Alex-f98/Circuitos2-FIUBA/Versión_Final/PCB-V3/TP-PCB/TP-PCB.png

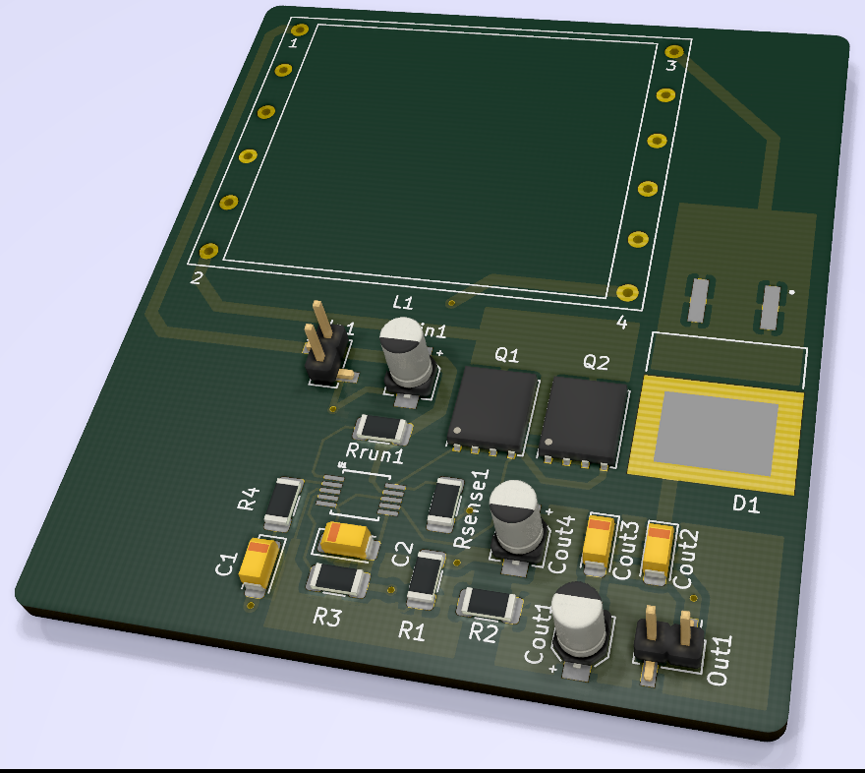
Versión_Final/PCB-V3/TP-PCB/TP-PCB.png
