Alex-f98/Circuitos2-FIUBA/README.md

Los archivos de cursas son muy pesados para subir al github.

Solo se sube el TP final del mismo, dentro esta el informe.
Como fue un tp en donde se nos hacia seguimiento se pidio que el informe sea breve y presente solo resultados.
