Alex-f98/Circuitos2-FIUBA/Versión_Final/Proyecto Flyback - Version Final.pdf

# Diseño de Circuitos Electrónicos - Proyecto Final - Rev.1

Brian Fuentes - Elías Urquiza - José F. González - Mauro Nacachian

Julio 2021

## Índice

1. Especificaciones | 2
2. Topología | 2
3. Diseño Teórico | 2
4. Componentes | 4
5. Simulaciones | 7
6. Diseño del PCB | 10
7. Referencias | 11

Rev.1 Se definen las especificaciones.

Batería /

Alternador

11 V - 14 V
Encendedor
Vin Iin

Regulador

Vout Iout

Notebook

Pout = 97,5 W

19.5 V @ 5 A

Figura 1: Diagrama de Bloques con Especificaciones.

## 1. Especificaciones

Nos interesa diseñar un regulador conmutado para alimentar Notebooks conectadas al enchufe ’encededor’ de un automóvil como se muestra en la Figura 1. La tensión a regular proviene de la batería de valor nominal 12 V y debe elevarse al estandar de cargadores de notebook 19,5V@5A, luego la topología de conmutación deberá ser elevadora.
Las especificaciones a cumplir se resumen en el Cuadro 1.
Entrada | Salida | Regulador
Tensión | 11 V - 14 V | 19.5 V
Corriente | 9.2A | 5 A
Potencia | 110 W | 98,5 W
Eficiencia | 91 %

Cuadro 1: Especificaciones del regulador.

## 2. Topología

Para la selección de la topología se revisaron los estándares adoptados por la industria y resumidos en la Figura 2. El punto de operación elegido está levemente fuera de los estándares que tomamos como referencia, pero teniendo en cuenta que estos estándares fueron definidos empíricamente en 1990, y determinados por el estrés que pueden soportar los transistores de conmutación, consideramos que con las frecuencias de conmutación de los controladores actuales es posible salir de ese estándar de forma segura. En ese caso elegimos la fuente Flyback por su simplicidad y bajo costo, según los consejos de la cátedra.

## 3. Diseño Teórico

En la Figura 3 se muestra el esquemático simplificado de un regulador Flyback aislado. En un análisis preliminar se espera que el transistor de conmutación deberá soportar las siguientes condiciones
(
IDp ≈ 5,5 ×

P out
V in = 5,5 ×

100 W
11 V | = 50 Ap
VDp | ≈ V outmax

N1
N2 + V in = 30 V p

(1)

### 3.1. Frecuencia de Conmutación

La selección de la frecuencia está dada por una relación de compromiso entre los tamaños de los inductores y cuanta pérdida por conmutación se puede admitir. Mayores inductores aumentan la eficiencia pero son fisicamente más grandes y costosos.

Pout (W)

Vin (V)

1000

100

10

10 | 100 | 1000
Dominio Flyback | Half/Full Bridge

100 W

12 V

Figura 2: Diagrama de topologías adoptadas por la industria según la aplicación. Fuente: Practical Switching Power Supply Design – Marty Brown – Motorola. 1990

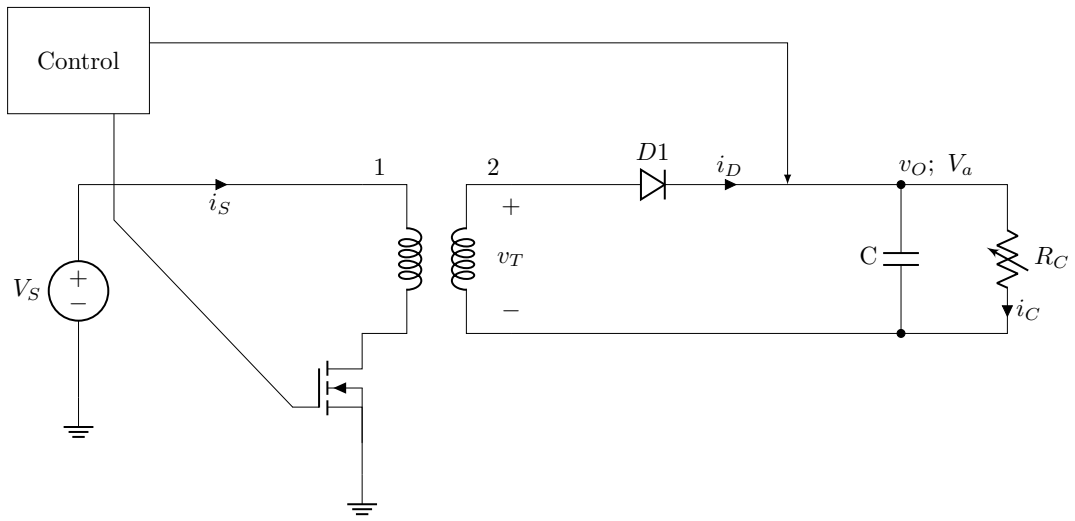
[picture p2: figure]
Control

Figura 3: Esquematico simplificado de un regulador Flyback aislado.

### 3.2. Ciclo de Trabajo

Cuando se opera al límite entre modo continuo y discontinuo el ciclo de trabajo relaciona la tensión de entrada con la salida según

D =

V out ·

N1
N2
V in +

N1
N2

V out

(2)

Cuando la tensión de entrada es mínima - 11 V - el ciclo de trabajo es máximo. Podemos fijar ese ciclo máximo a un 60 % y obtener una relación

N1
N2
= 0, 85 | (3)

### 3.3. Inductancia del Primario

El punto límite de funcionamiento es cuando la tensión de entrada es mínima y la corriente por el primario llega a un pico de

I1p = (1 −

∆IIN

2.IINavg

).P out.V in + V out.N
V in.V out.η.N
= 14A | (4)

Este valor condiciona a la tecnología de componentes para el dispositivo semiconductor y los inductores. Determina también la máxima dimensión del primario, luego la inductacia primaria a mínima entrada y máxima potencia de salida es

L1 =

V inmin × Dmax
∆I1 × f
= 62 uF | (5)

L2 = N

2
.L1 = 70uF | (6)
(
V pri = V sec ×

N1
N2
V sec = VD + V out

(7)

## 4. Componentes

### 4.1. Lista

Controlador | LTC1871
RRUN | 1 MΩ | -
R1 | 20 kΩ 1 % | -
R2 | 1,3 kΩ 1 % | -
R3 | 250 kΩ
R4 | 20 kΩ
RSENSE | 9 mΩ 1 % | IRC / TT Electronics
R4 | 20 kΩ | -
C1 | 35 nF | -
C2 | 4.7 uF 10V | X5R Kemet
CIn | 33 uF 35V | Tántalo
COut1 | 330 uF 35V | Electrolitico
COut2 | 330 uF 35V | Electrolitico
COut3 | 10 uF 35V | X5R Kemet
COut4 | 10 uF 35V | X5R Kemet
Diodo Schottky | MBR20100CT | TO-263
MOSFET | BSC035N04LS | -

### 4.2. Elección detrás de los elementos

En base al circuito propuesto de la figura 3 elegimos aquellos componentes reales, y la mayoría de ellos fácilmente adquiribles en el país, que nos permiten trabajar en el rango de entrada/salida propuesto.
Primeramente. elegimos el circuito integrado que actuará como controlador, decidiéndonos por el LTC1871 puesto que es apto para trabajar en modo de operación flyback, y requiere pocos componentes. Además, puede sensar al transistor de conmutación de dos formas distintas, una de ellas exclusiva para este controlador, pero finalmente decidimos manejarnos con el método de sensado tradicional, colocando el pin de sensado en el source.
Por otro lado, los transistores MOSFET elegidos son los BSC035N04LS, puesto que estos logran trabajar correctamente a la frecuencia de conmutación requerida, aunque para evitar que disipen demasiada potencia, se determinó que utilizar dos de ellos en paralelo era la opción óptima. Cabe destacar que estos componentes son los únicos que no se encuentran fácilmente en el país, por lo que en caso de no adquirirlos proponemos como reemplazo el transistor AOD4184. Otro componente de importancia es el diodo a utilizar, dado que este tendra una cierta caida de tensión entre sus bornes y debe ser capaz de soportar la corriente de salida y la frecuencia de conmutación de esta. Nos decidimos por el modelo MBR20100CT, el cual son 2 diodos Schottky en paralelo y tienen una caida de tension en directa de aproximadamente 0.8 V a la corriente instantanea de salida ( 10A). Una observacion respecto a este componente, es que en el pais se consigue facilmente con encapsulado TO-220, pero nosotros decidimos utilizar con montaje superficial, por lo tanto en caso de no conseguirlo se lo puede reemplazar por el modelo mencionado.
Finalmente, basándonos en el diseño del inductor acoplado, elegimos utilizar un núcleo E42/21/20-3F3-E250 de ferrite, para el cual se puede conseguir un carretel para colocarlo en el circuito.
A continuación se puede ver un esquema del circuito completo, seguido de una descripción de los componentes pasivos utilizados.

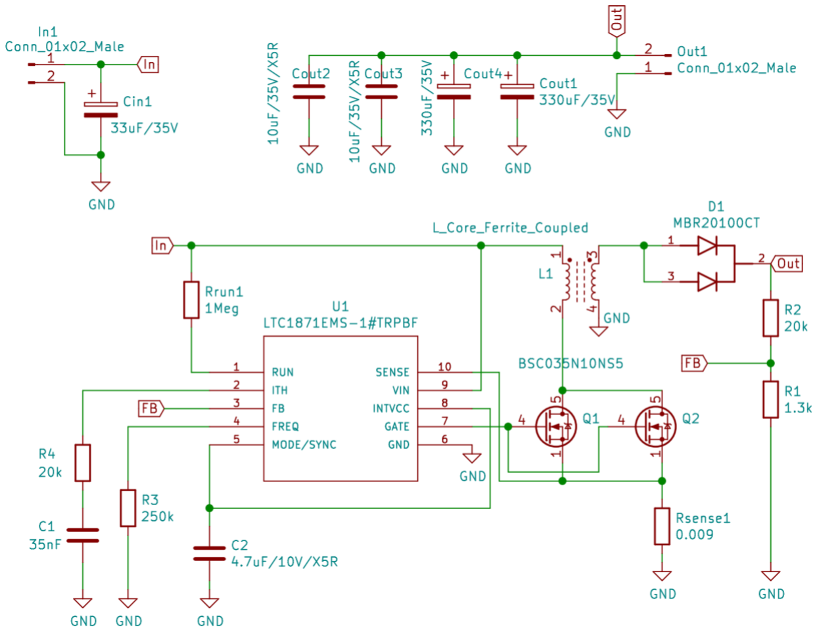
[picture p3: figure]

Figura 4: Esquema en Kicad del circuito diseñado.

La resistencia R3 se eligio en base a la siguiente curva del LTC1871 de manera de obtener 100 kHz.

### 4.3. Capacitores

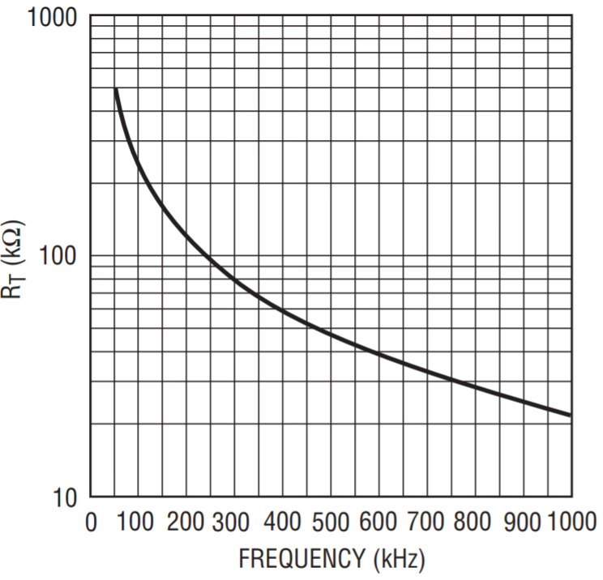
[picture p4: figure]

Los capacitores de salida los elegimos basándonos en la hoja de datos del LTC1871. Buscamos que todos los capacitores soporten una tensión de 35 V como mínimo. Para satisfacer la capacidad

mínima (COUT >

IOUTmax
0, 01VOUT f

= 250uF) seleccionamos dos capacitores electrolíticos Panasonic

de 330uF en paralelo, junto con otros 2 capacitores de bajo ESR. Para estos últimos capacitores buscamos que su dieléctrico sea del tipo X5R marca Kemet, con un valor de 10uF, de este modo podemos lograr una ESR (del orden de los 5 mΩ) baja (con un ripple de salida del 2 %). Basándonos en la nota de aplicación de la hoja de datos, la elección del capacitor de entrada no es crítica, por lo tanto decidimos utilizar un electrolitico de Tántalo 33uF y 35V.

### 4.4. MOSFET

Tal como se mencionó, utilizamos el modelo BSC035N04LS. A continuación se muestra la tabla de características máximas:

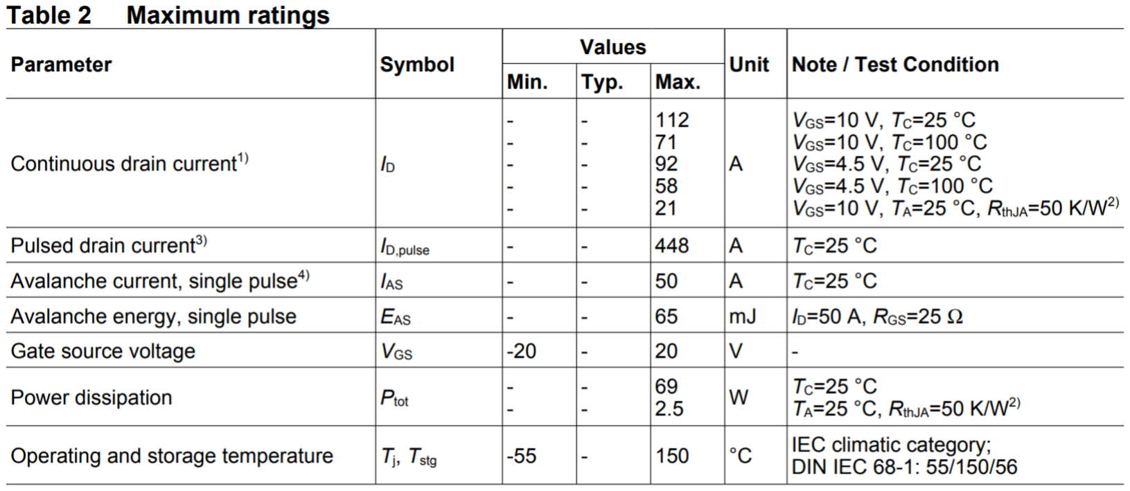
[picture p5: figure]

En el circuito se incorporan 2 transistores en paralelo para aliviar la disipación de potencia en cada transistor. Por otro lado, se integró la potencia en 1 segundo en cada transistor para verificar si necesitan disipador, y en base al resultado se concluyó que no es necesario.

### 4.5. Diodo

El diodo que porponemos es de tipo Schottky, y el modelo en particular es el MBR20100CT, que viene con 2 diodos en paralelo. A partir del grafico siguiente de la hoja de datos:

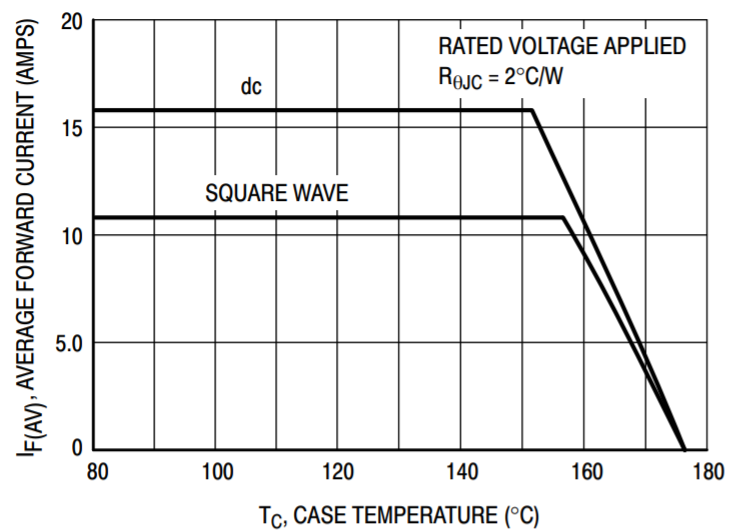
[picture p6: figure]

Integramos la corriente que circula por el diodo para obtener en promedio de un segundo, el resultado da aproximadamente 5 A, lo cual esta por debajo de los 10 A, entonces podemos concluir que para su correcto funcionamiento no requiere un disipador.

## 5. Simulaciones

### 5.1. Inductancias Parásitas

Para estimar las inductancias parásitas de las pistas del circuito se utiliza la ecuación de inductor según las distintas áreas del PCB

L =

uN²A
l

≈ 1, 256

uH
l
A | (8)

Simulaciones sin considerar los efectos parasitos de las pistas y sin el agregado del snubber:

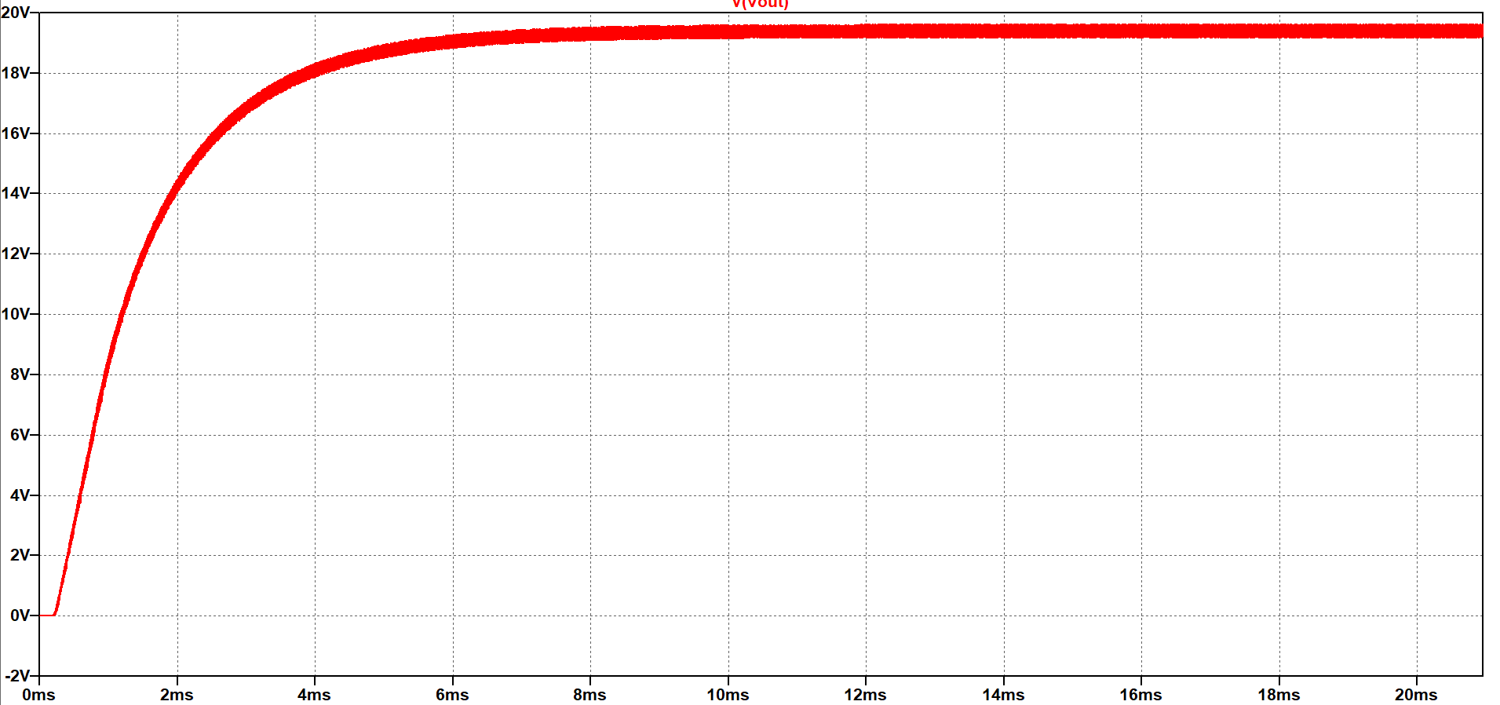
[picture p7: figure]

Figura 5: Tensión a la salida.

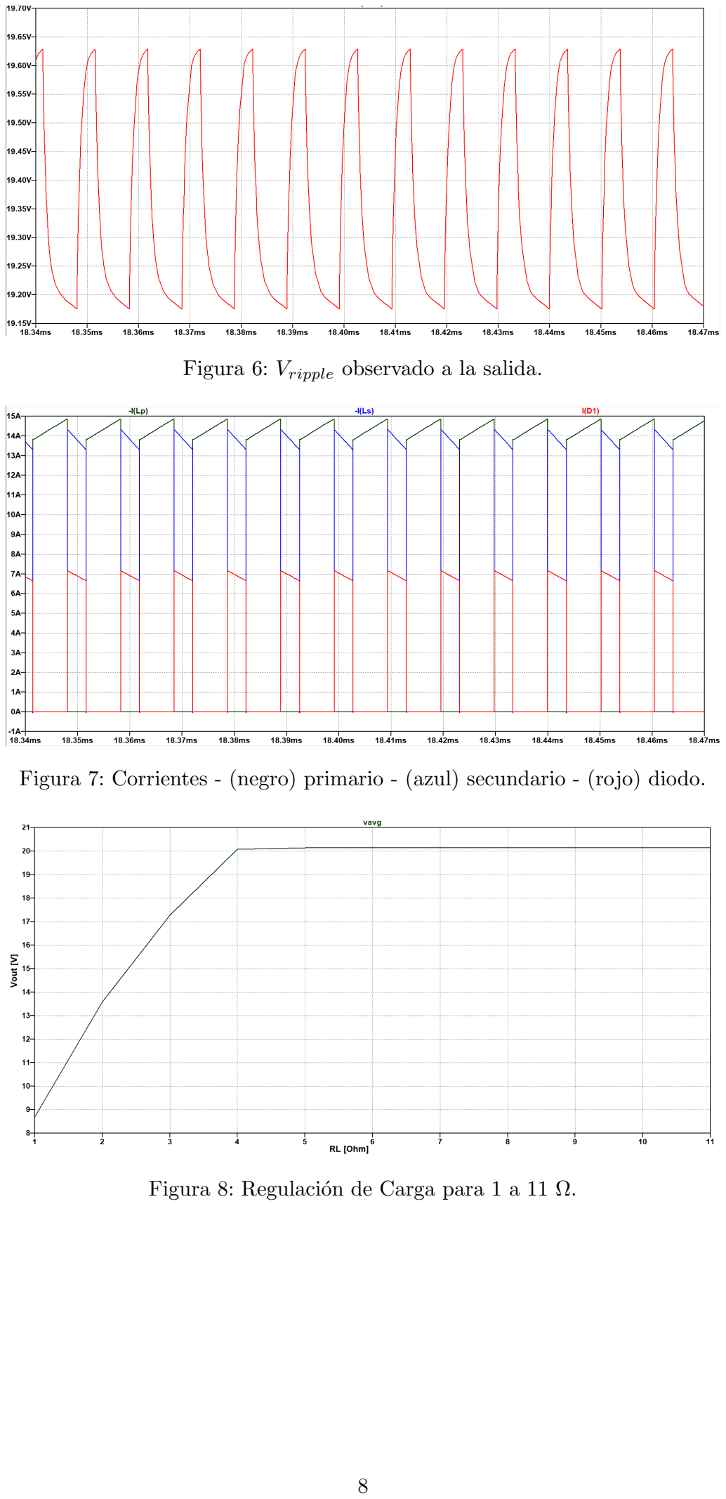
[picture p8: page 8]

Figura 6: Vripple observado a la salida.

Figura 7: Corrientes - (negro) primario - (azul) secundario - (rojo) diodo.

Figura 8: Regulación de Carga para 1 a 11 Ω.

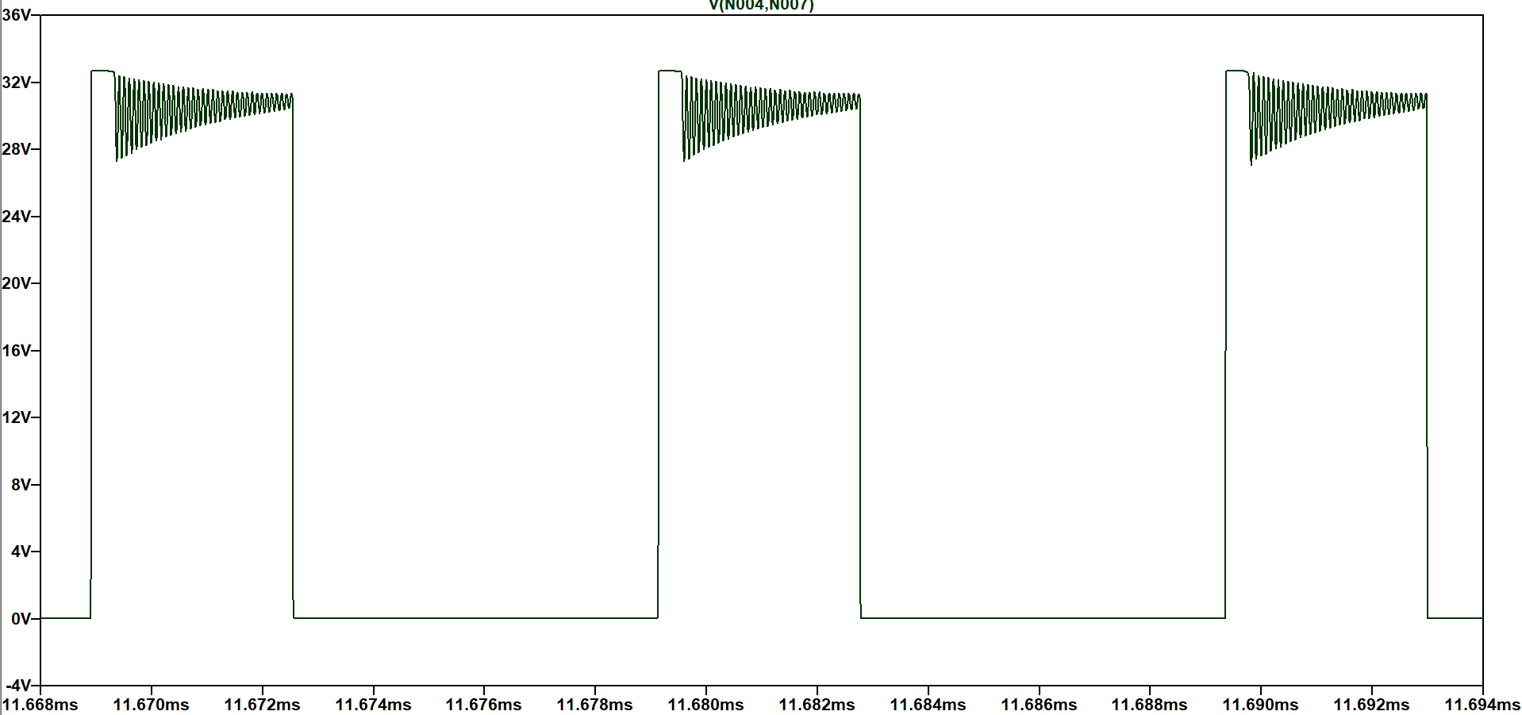
[picture p9: figure]

Figura 9: Ringing en la tensión VDS del Mosfet incluyendo efectos parásitos.

### 5.2. Regulación de carga

En las siguientes simulaciones pudimos corroborar que el regulador es capaz de estabilizar su comportamiento rápidamente ante variaciones de entrada o de la carga.

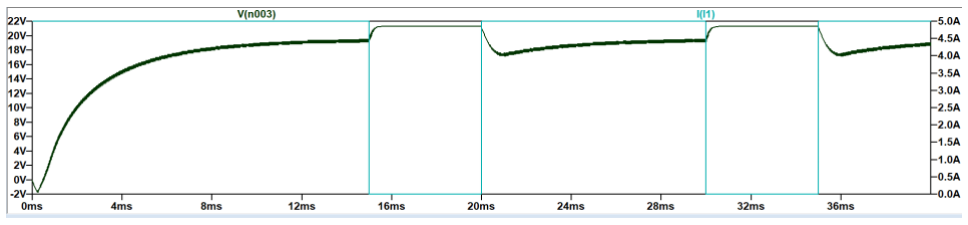
[picture p10: figure]

Figura 10: En este caso se simula con una fuente de 5A que se apaga a los 10ms y se vuelve a encender 5ms después.

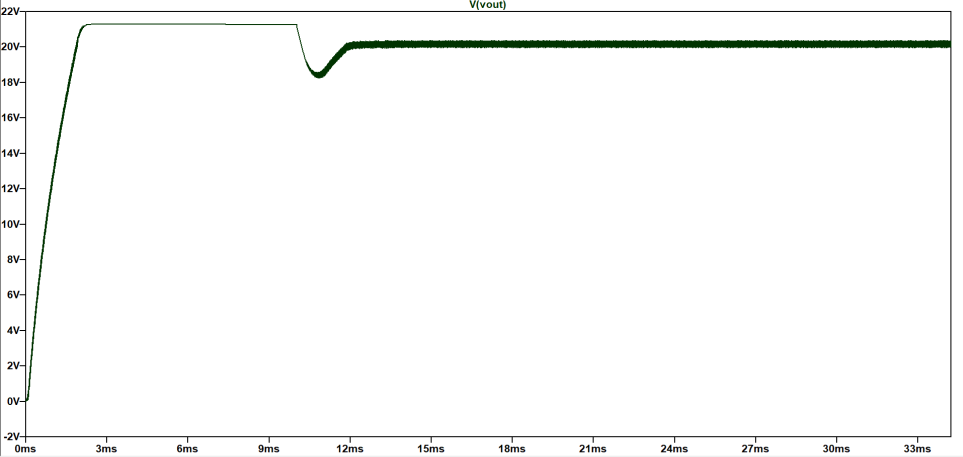
[picture p11: figure]

Figura 11: Simulación colocando una carga de 4Ω después de 10ms.

## 6. Diseño del PCB

Para poder diseñar el PCB, se tuvo que diseñar el footprint del carrete sobre el cual se colocaría el núcleo de ferrita, basándonos en la información provista por el fabricante. De esta forma se pudo determinar el recorrido de las pistas. Tuvimos también en cuenta la posibilidad de inductancias parásitas al colocar el plano de tierra debajo del inductor, por lo que se eligió no cubrir la zona debajo de este.

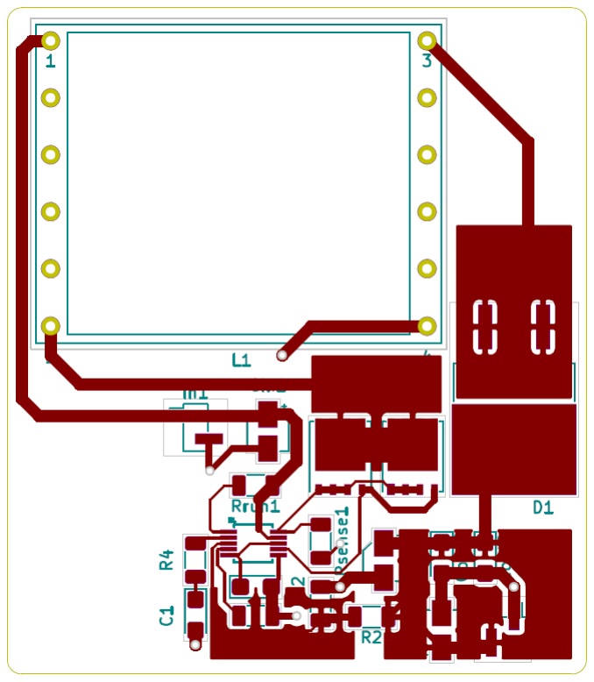
[picture p12: figure]

Figura 12: Diseño de PCB mostrando únicamente las pistas frontales.

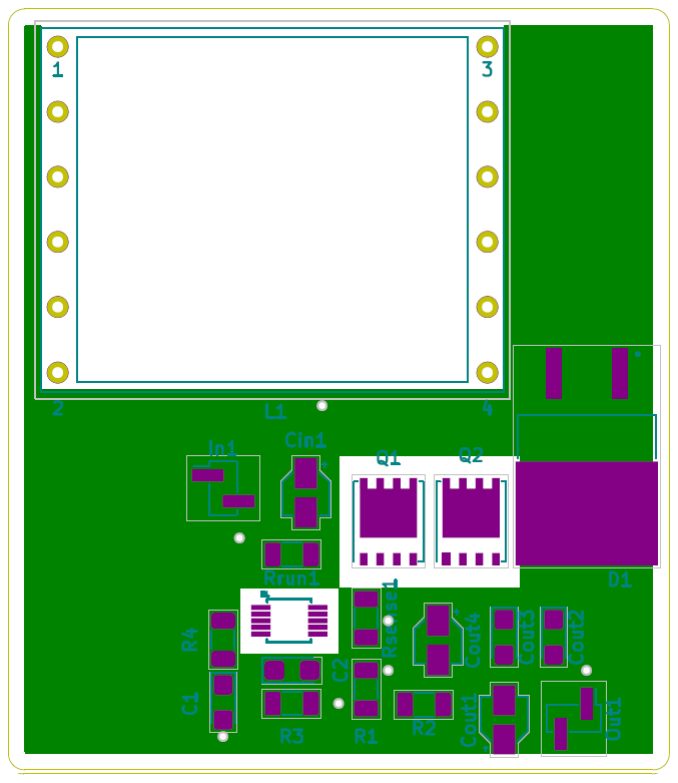
[picture p13: figure]

Figura 13: Diseño de PCB mostrando únicamente las pistas dorsales.

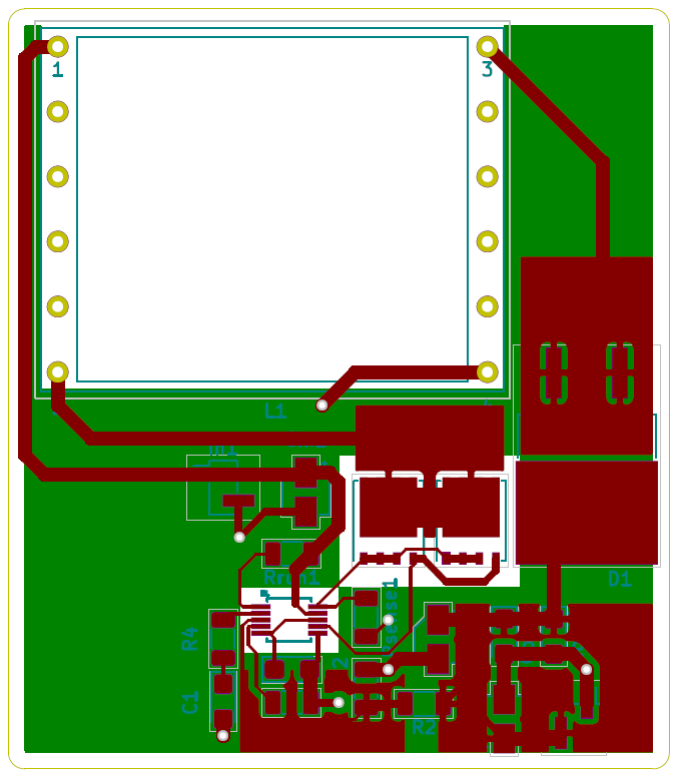
[picture p14: figure]

Figura 14: Diseño de PCB mostrando las pistas de ambos lados.


Figura 15: Modelo en tres dimensiones del PCB diseñado.

## 7. Referencias

Practical switching power supply design I Marty Brown

Texas Instrument - Application Note - How to Design Flyback Converter With LM3481 Boost

Texas Instrument - Application Note - How to design an Isolated Flyback using LM5155

On Semi - Application Note - Design Guidelines for Flyback Converters Using FSQ-series Fairchild Power Switch (FPS™)

Power Electronics Handbook - Muhammad Rashid - 3rd. edition Controller

Notas de Cátedra.
