Alex-f98/Circuitos2-FIUBA/Versión_Final/PCB-V3/TP-PCB/PCB.pdf

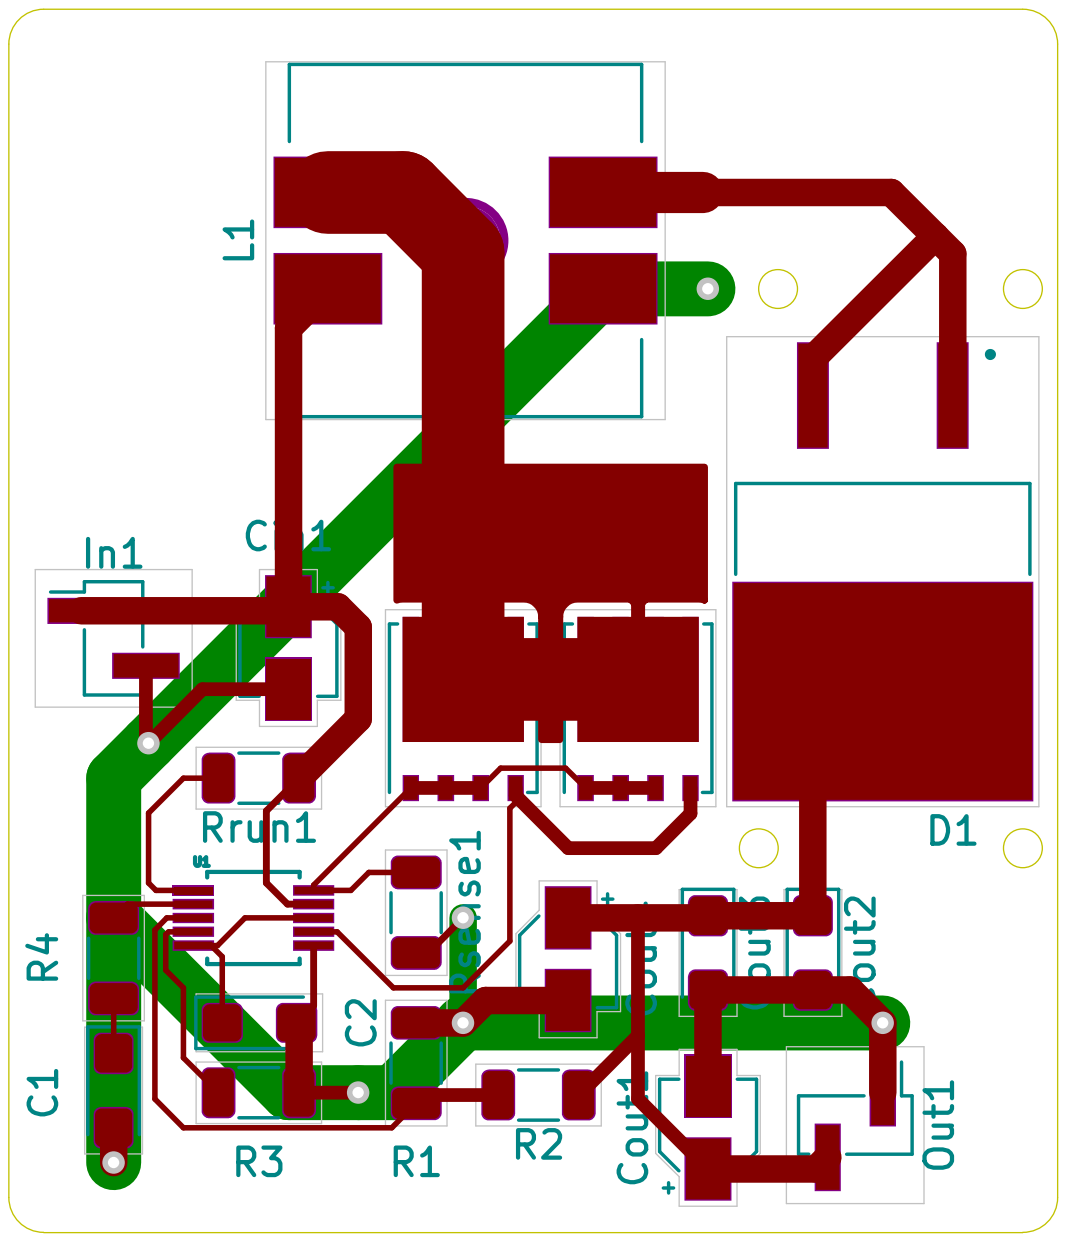
[picture p15: page 1]
