Alex-f98/Circuitos2-FIUBA/Versión_Final/Flyback_Converter_w_LTC1871_v4.asc

C1: cap; 35n
C2: cap; 4.7µ; V=10 Irms=4.27 Rser=0.0182602 Lser=0 mfg="KEMET" pn="C1206C475K8PAC" type="X5R"
C3: cap; 680µ
Cin: polcap; 33µ; V=35 Irms=1.86052 Rser=0.065 Lser=0 mfg="KEMET" pn="T521D336M035ATE065" type="Tantalum"
Cout1: polcap; 330µ; V=35 Irms=1.01 Rser=0.065 Lser=0 mfg="Panasonic" pn="ECA1VFQ331" type="Al electrolytic"
Cout2: polcap; 330µ; V=35 Irms=1.01 Rser=0.065 Lser=0 mfg="Panasonic" pn="ECA1VFQ331" type="Al electrolytic"
Cout3: cap; 10µ; V=35 Irms=8.06 Rser=0.00577565 Lser=0 mfg="KEMET" pn="C1210C106K6PAC" type="X5R"
Cout4: cap; 10µ; V=35 Irms=8.06 Rser=0.00577565 Lser=0 mfg="KEMET" pn="C1210C106K6PAC" type="X5R"
D1: schottky; MBR20100CT
D2: schottky; MBR20100CT
D3: diode
I1: current; PULSE(5 0 15m 1p 1p 5m 15m)
L1: ind; 1µ
Lp: ind2; 65µ; Rser=14m
Lparasito: ind; 0.1µ
Ls: ind2; 70µ; Rser=14m
M1: nmos; BSC035N04LS
M2: nmos; BSC035N04LS
R1: res; 1.3k; tol=1
R2: res; 20k; tol=1
R3: res; 250k
R4: res; 20k
R5: res; 2.2k
RL: res; 4
Rsense: res; 0.009; tol=1
Run: res; 1Meg
S1: sw; MYSW
U1: LTC1871
V1: voltage; SINE(12 0 100k); Rser=0.01
V2: voltage; PULSE(0 5 10m 0 0 40m 42m 100)
Named nets: 0, Vin, FB, Vout
.tran 0 40m 0
K1 Lp Ls 1
.save V(Vout)
.step param r 1 11 1
.measure Vavg avg V(Vout)
.option plotwinsize = 0 numdgt=15
.model MYSW SW(Ron=1 Roff=1Meg Vt=.5 Vh=-.4)
Regulacion de carga
