Alex-f98/Circuitos2-FIUBA/Versión_Final/PCB-V3/TP-PCB/TP-PCB.kicad_pcb

## KiCad design Versión_Final/PCB-V3/TP-PCB/TP-PCB.kicad_pcb (2025-02-20)

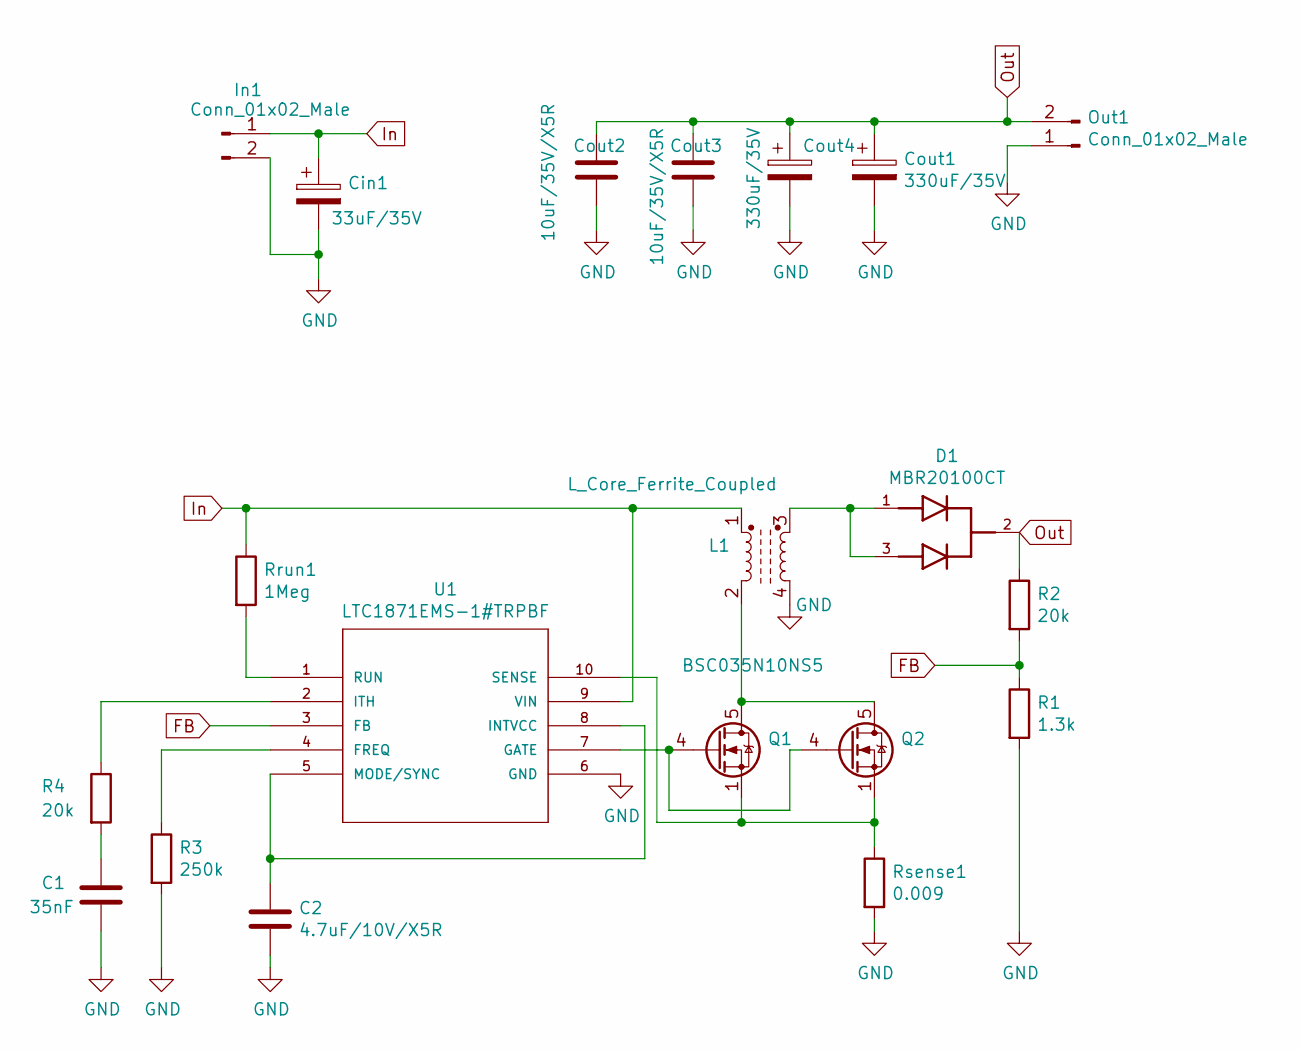
[picture p16: schematic TP-PCB.sch]

Parts:
C1: 35nF; CP_EIA-3216-18_Kemet-A
C2: 4.7uF/10V/X5R; CP_EIA-3216-18_Kemet-A
Cin1: 33uF/35V; CP_Elec_3x5.3
Cout1, Cout4: 330uF/35V; CP_Elec_3x5.3
Cout2, Cout3: 10uF/35V/X5R; CP_EIA-3216-18_Kemet-A
D1: MBR20100CT; TO254P1521X483-4N; PARTREV 8-2
In1: Conn_01x02_Male; PinHeader_1x02_P2.00mm_Vertical_SMD_Pin1Left
L1: L_Core_Ferrite_Coupled; ALT_Carrete_E42-21-20
Out1: Conn_01x02_Male; PinHeader_1x02_P2.00mm_Vertical_SMD_Pin1Left
Q1, Q2: BSC035N10NS5; TDSON-8-1
R1: 1.3k; R_1206_3216Metric
R2, R4: 20k; R_1206_3216Metric
R3: 250k; R_1206_3216Metric
Rrun1: 1Meg; R_1206_3216Metric
Rsense1: 0.009; R_1206_3216Metric
U1: LTC1871EMS-1#TRPBF; MSOP-10_MS; MANUFACTURER_PART_NUMBER ltc1871ems7

Connections:
FB: R1.1, R2.2, U1.3 (FB)
GND: C1.2, C2.2, Cin1.2, Cout1.2, Cout2.2, Cout3.2, Cout4.2, In1.2, L1.4, Out1.1, R1.2, R3.2, Rsense1.2, U1.6 (GND)
In: Cin1.1, In1.1, L1.1, Rrun1.1, U1.9 (VIN)
unnamed: C1.1, R4.2
unnamed: C2.1, U1.5 (MODE/SYNC), U1.8 (INTVCC)
unnamed: D1.1, D1.3, L1.3
unnamed: L1.2, Q1.5 (D), Q2.5 (D)
unnamed: Q1.1 (S), Q1.2 (S), Q1.3 (S), Q2.1 (S), Q2.2 (S), Q2.3 (S), Rsense1.1, U1.10 (SENSE)
unnamed: Q1.4 (G), Q2.4 (G), U1.7 (GATE)
unnamed: R3.1, U1.4 (FREQ)
unnamed: R4.1, U1.2 (ITH)
unnamed: Rrun1.2, U1.1 (RUN)
Out: Cout1.1, Cout2.1, Cout3.1, Cout4.1, D1.2, Out1.2, R2.1

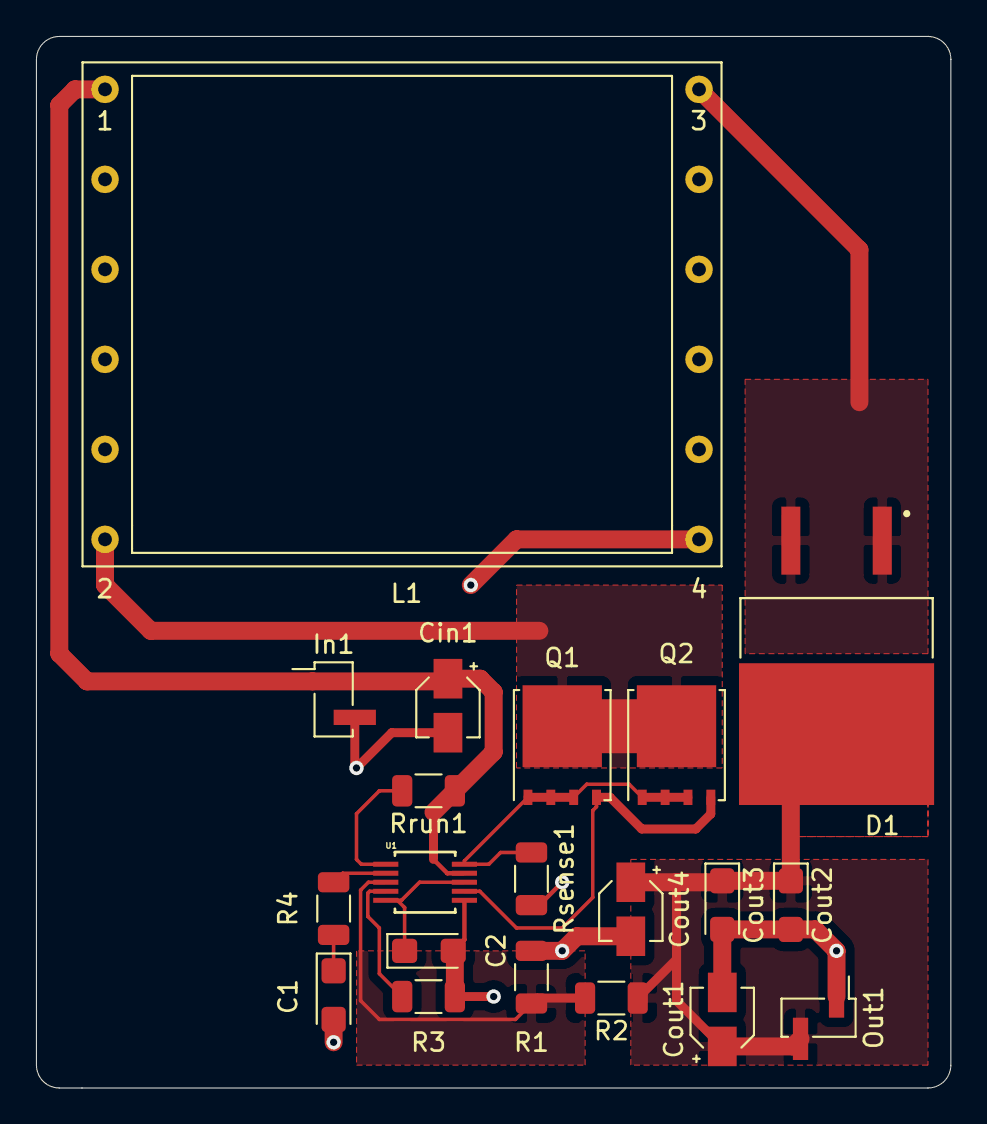
[picture p17: board TP-PCB.kicad_pcb from above]

Board: 2 copper layers, 50.8 x 58.4 mm, 20 parts (0 on the bottom side), 13 nets.
